Cedric02700/PortePoulailler/Schema KiCad/PortePoulailler.kicad_pcb

## KiCad design Schema KiCad/PortePoulailler.kicad_pcb (2020-03-29)

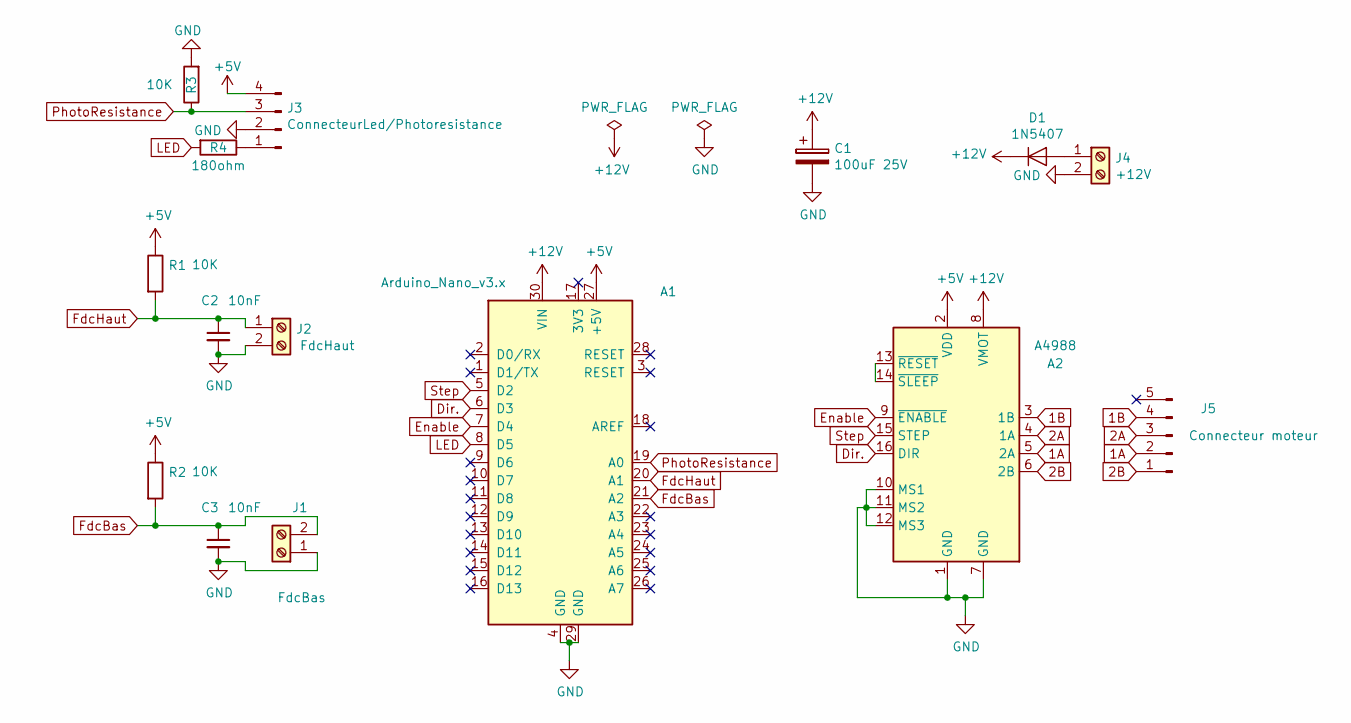
[picture p2: schematic PortePoulailler.sch]

Parts:
A1: Arduino_Nano_v3.x; Arduino_Nano
A2: A4988; Pololu_Breakout-16_15.2x20.3mm
C1: 100uF 25V; CP_Radial_D6.3mm_P2.50mm
C2, C3: 10nF; C_Disc_D5.0mm_W2.5mm_P2.50mm
D1: 1N5407; D_DO-201AD_P5.08mm_Vertical_AnodeUp
J1: FdcBas; TerminalBlock_Altech_AK300-2_P5.00mm
J2: FdcHaut; TerminalBlock_Altech_AK300-2_P5.00mm
J3: ConnecteurLed/Photoresistance; JST_XH_B04B-XH-A_1x04_P2.50mm_Vertical
J4: +12V; TerminalBlock_Altech_AK300-2_P5.00mm
J5: Connecteur moteur; JST_XH_B05B-XH-A_1x05_P2.50mm_Vertical
R1, R2, R3: 10K; R_Axial_DIN0414_L11.9mm_D4.5mm_P15.24mm_Horizontal
R4: 180ohm; R_Axial_DIN0414_L11.9mm_D4.5mm_P15.24mm_Horizontal

Connections:
1A: A2.5 (2A), J5.2
1B: A2.3 (1B), J5.4
2A: A2.4 (1A), J5.3
2B: A2.6 (2B), J5.1
+5V: A1.27 (+5V), A2.2 (VDD), J3.4, R1.1, R2.1
+12V: A1.30 (VIN), A2.8 (VMOT), C1.1, D1.1 (K)
Dir.: A1.6 (D3), A2.16 (DIR)
Enable: A1.7 (D4), A2.9 (~ENABLE)
FdcBas: A1.21 (A2), C3.1, J1.2, R2.2
FdcHaut: A1.20 (A1), C2.1, J2.1, R1.2
GND: A1.4 (GND), A1.29 (GND), A2.1 (GND), A2.7 (GND), A2.10 (MS1), A2.11 (MS2), A2.12 (MS3), C1.2, C2.2, C3.2, J1.1, J2.2, J3.2, J4.2, R3.2
LED: A1.8 (D5), R4.2
unnamed: A2.13 (~RESET), A2.14 (~SLEEP)
unnamed: D1.2 (A), J4.1
unnamed: J3.1, R4.1
PhotoResistance: A1.19 (A0), J3.3, R3.1
Step: A1.5 (D2), A2.15 (STEP)

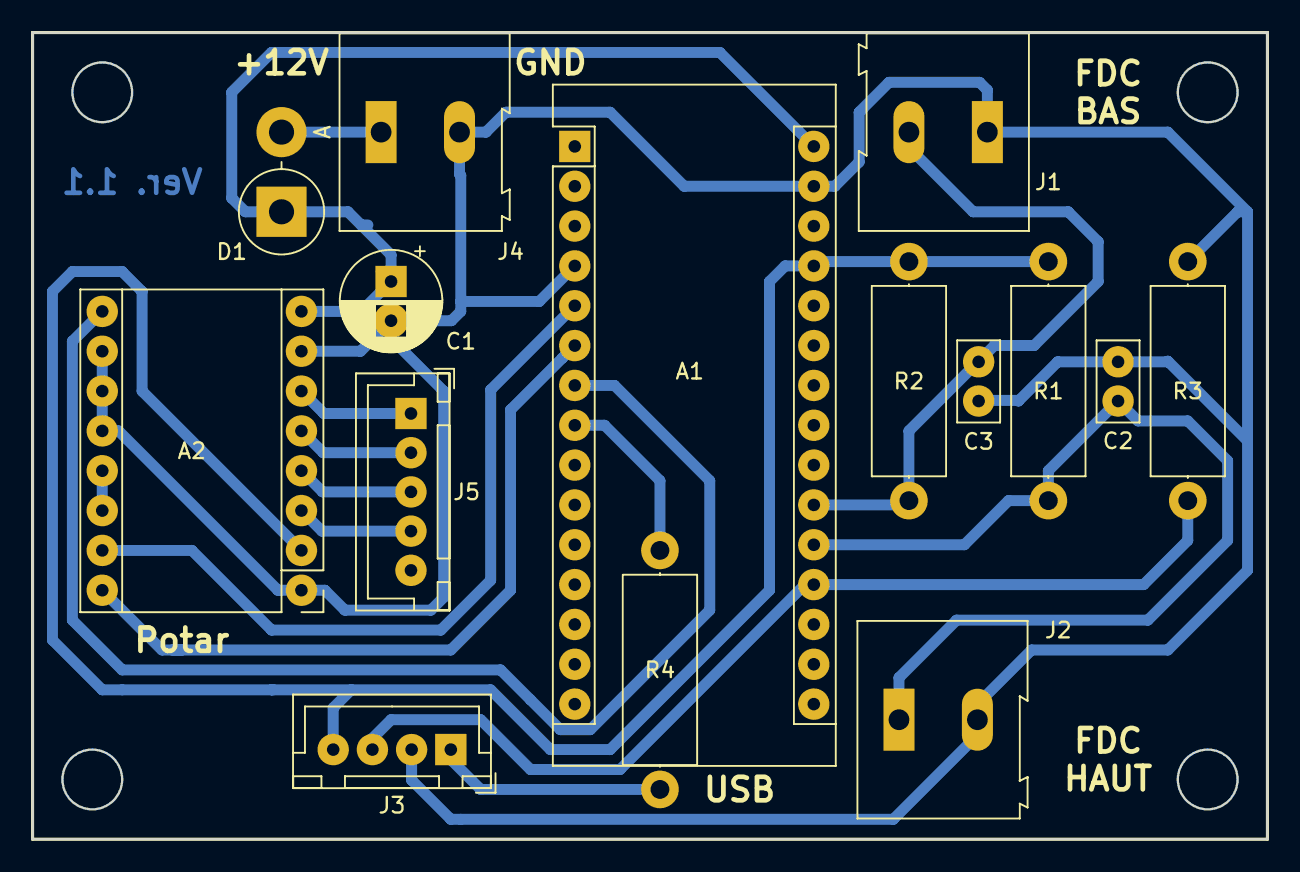
[picture p3: board PortePoulailler.kicad_pcb from above]

Board: 2 copper layers, 78.7 x 51.4 mm, 15 parts (0 on the bottom side), 17 nets.
