Cedric02700/PortePoulailler/(commit log)

2019-03-24 Ajout de quelque fonction. Travail en cours de progression.
2019-03-26 Ajout de quelques fonctions plus correction de bug.
    [portePoulailler.ino]
2019-03-26 Correction de bug
2019-04-17 Ajout schema Kicad
    [PortePoulailler.kicad_pcb, PortePoulailler.sch]
2019-12-07 Correction Bug calibration().
2020-03-29 Mise a jour et début de rédaction de la notice
    [PortePoulailler.kicad_pcb, PortePoulailler.sch]
